drewarnett/10gig-fox-shield/docs/10g fox shield.pdf

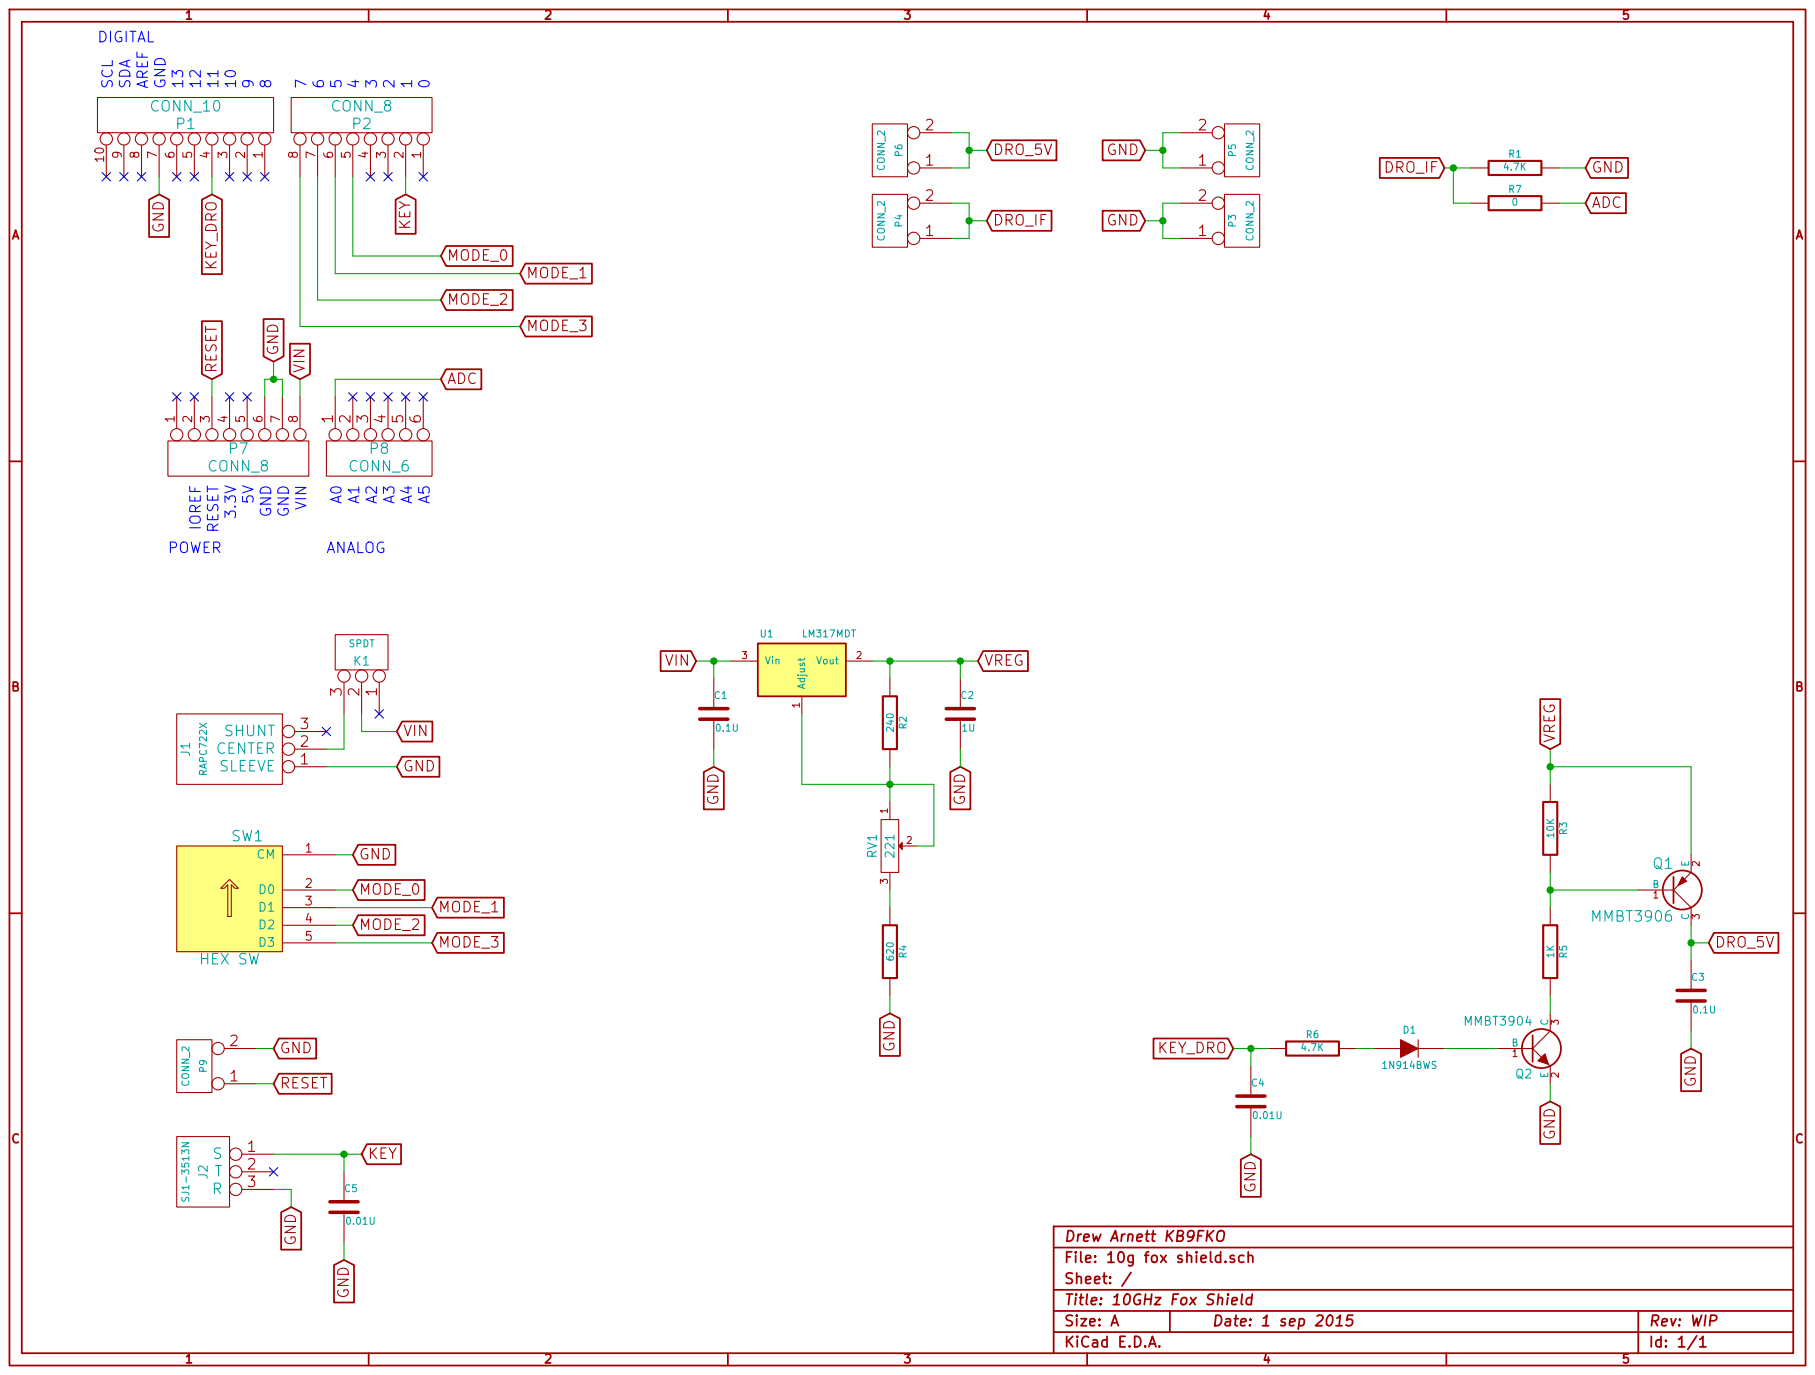
[picture p1: page 1]

DIGITAL SCL SDA AREF GND 13121110

0 POWER ANALOG A0A1A2A3A4A5 VIN GND GND5V 3.3V IOREF RESET GND GND RESET VIN KEY_DRO

File: 10g fox shield.sch
Sheet: /
Title: 10GHz Fox Shield
KiCad E.D.A.
